chuckcoffee/hukyroaster/README.md

# hukyroaster

<h1>Huky Stove – Gas Automation</h1>

<h2>Materials ~$47.00 CAD</h2>
-	Arduino 
-	Timing Belt and Pulley
-	Scrap wood used for motor mount and track system

Smraza Super Starter Kit (Arduino Clone Kit with stepper motor) - $35.99 Cdn
https://www.amazon.ca/gp/product/B06XXYVWVJ/ref=ppx_yo_dt_b_search_asin_title?ie=UTF8&psc=1
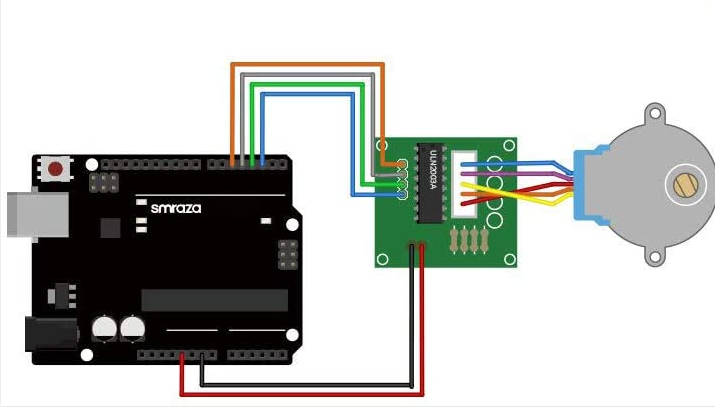
[picture p1: pics/arduino_motor.png]
arduino_motor Arduino setup with motor

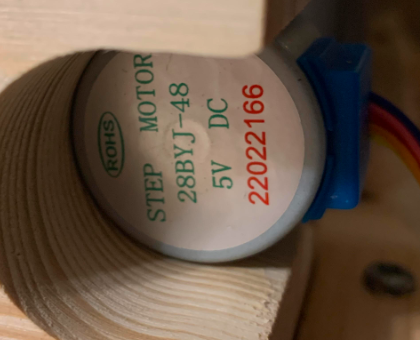
[picture p2: pics/stepper_motor.png]
stepper_motor


Fularr 3D Printer  2mm Pitch/6 mm shaft dia (matches stepper motor and Huky needle valve) - $11.90
https://www.amazon.ca/gp/product/B07PBXGL74/ref=ppx_yo_dt_b_asin_title_o08_s00?ie=UTF8&psc=1
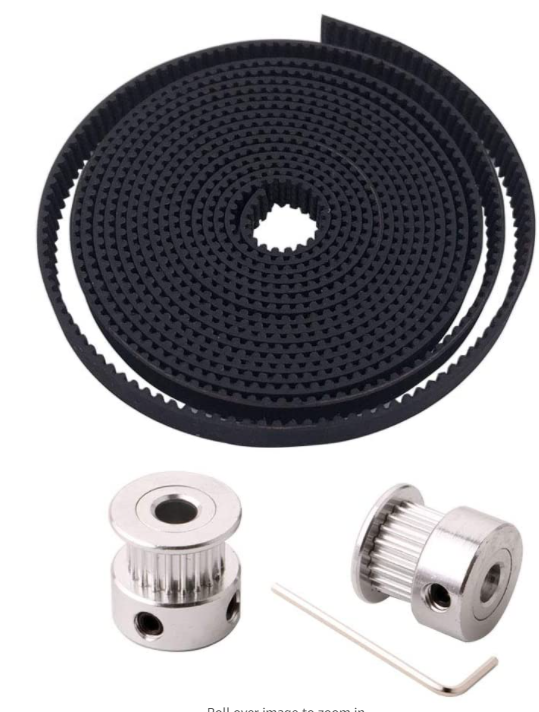
[picture p3: pics/belt.png]
belt


<h2>Files Used</h2>
roaster.ino - Program to run on arduino  <br>
arduinoCommunicator.py - Runs in bg at start, receives all commands from artisanprog calls, sends to arduino over serial connection <br>
artisanprog.py - Sends commands to arduinoCommunicator on button presses or events  <br>
e.g. artisanprog.py KPAI 50 (Set motor position to 50% of kpa_max)

<h2>Initial Setup Steps</h2>
1. Download python 2.7 https://www.python.org/downloads/release/python-278/ <br>

2. Load Arduino script onto Arduino (roaster.ino) <br>

	a. Test motor function <br>

3. Setup Computer to have Artisan interface with Stepper Motor <br>

	a. Create folder for Artisanprog.py and Arduinocommunicator.py and save files there <br>

	b. Setup buttons in artisan to trigger Artisanprog.py <br>

4. Test <br>

	a. From Command prompt execute Arduinocommunicator.py (so it is awake), or create a button in artisan to start the program (artisan setup part b) <br>
	
	b. From Artisan – click buttons and verify stepper motor is responding <br>
	
5. Calibration <br>

	a. Determine amount of rotation for full gas and calculate number of steps (based on stepper motor specs. For this motor, one rotation = 4076 steps; full gas was 1 1/4 turns so kpa max is 5095 steps) note: this was taken starting from 0.5 kpa to allow manual startup and because the motor was not powerful enough to reliably turn the valve if it was closed tight <br>

	b. Assign the max number of steps to kpa_max in artisanprog.py <br>

6. Artisan setup <br>

	a. In buttons tab, create buttons to start and stop the Arduino communicator. <br>
	
start_stop <br>

	b. In the events tab create a slider that gets the KPAI value and set it to burner; call program; C:\Python27\python.exe C:\Users\User\Documents\Arduino\hukyroaster-master\artisanprog.py KPAI {} <br>
	
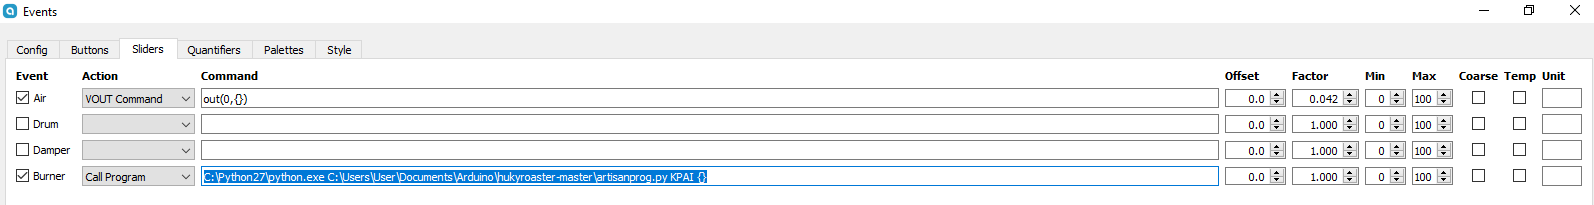
[picture p4: pics/artisan_sliders.png]
sliders
 <br>

	c. Press the button to start Arduino communicator, and then use the slider to adjust the gas until you reach kPa value you want to create a button for. Record these values (100 is max kPa, 0 is 0.5kPa) <br>

	d. Create a button for each kPa value, adjusting the number at the end of the documentation column command line as well as the value of the slider to the recorded values; C:\Python27\python.exe C:\Users\User\Documents\Arduino\hukyroaster-master\artisanprog.py KPAI 100 <br>
	
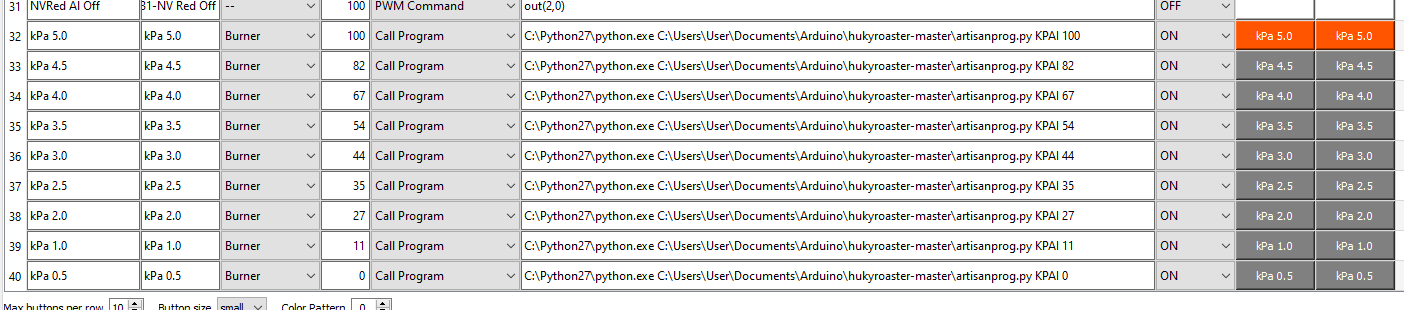
[picture p5: pics/artisan_buttons_2.png]
buttons_2


	e. Create alarms for each button to trigger at specified temperatures setting action to event button and the description as the button number (i.e. event Nr 22 is triggered when the bean temp reaches 340 which triggers event button 37, setting the gas to 2.5kPa) Note: set time to 00:00. This tells artisan to ignore time and only trigger based on temp. <br>

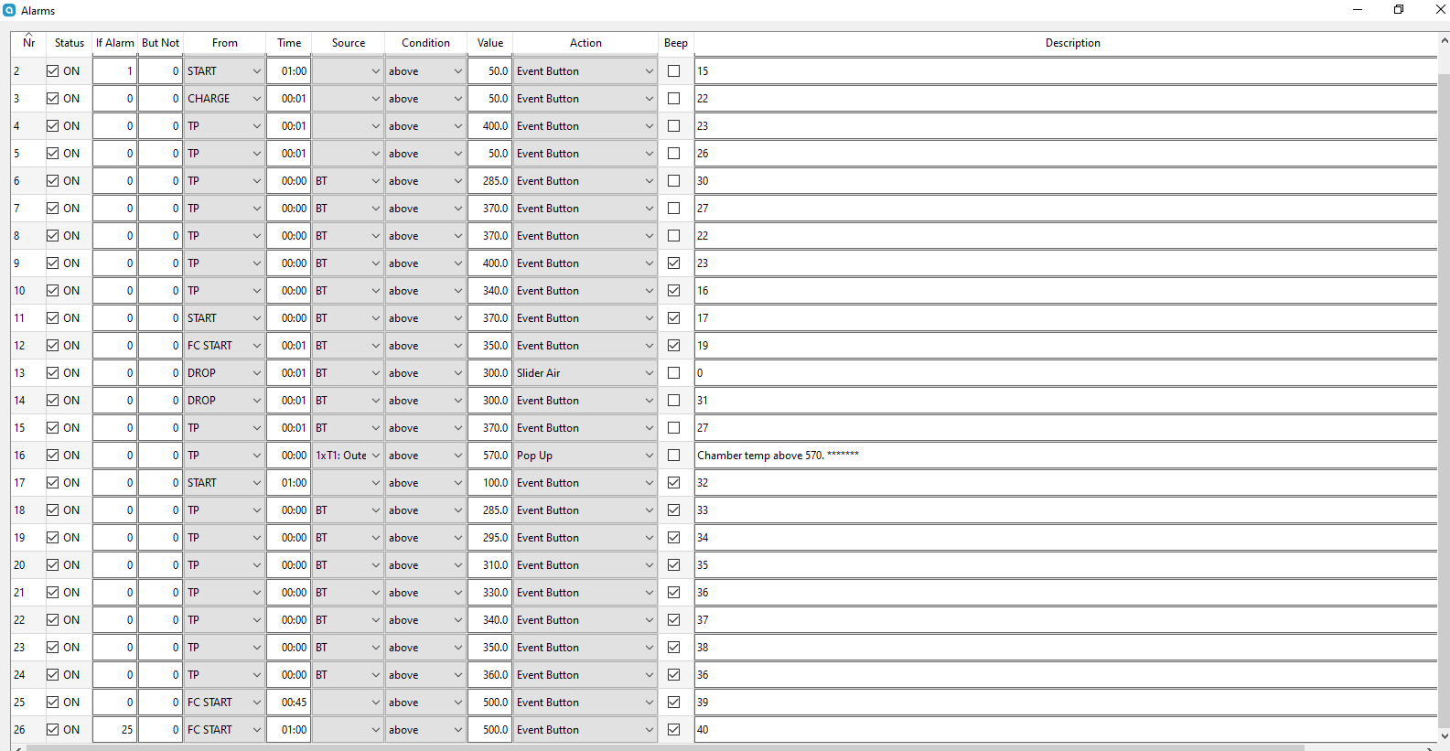
[picture p6: pics/artisan_events.png]
artisan_events

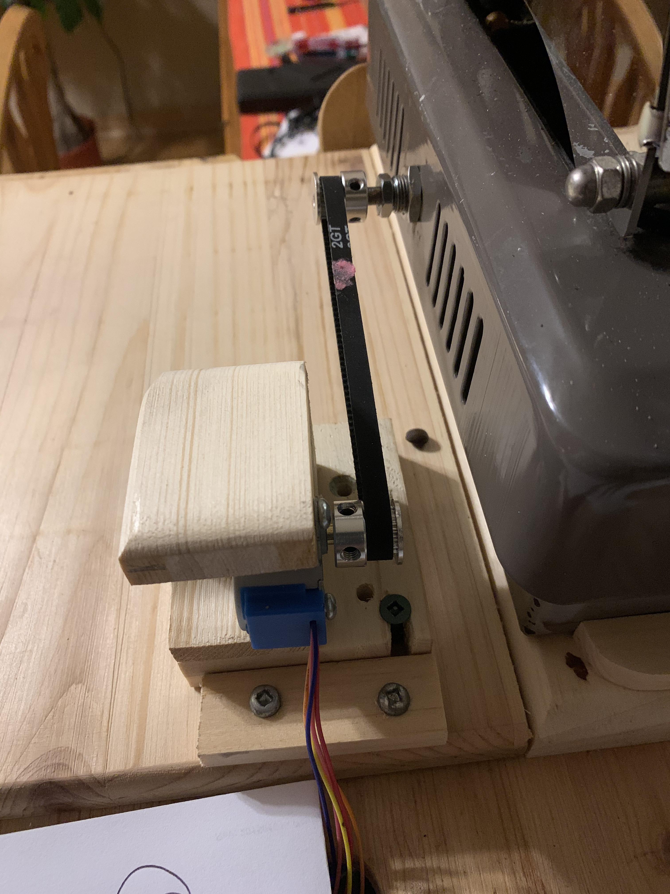
[picture p7: pics/motor_belt_setup.jpg]
setup

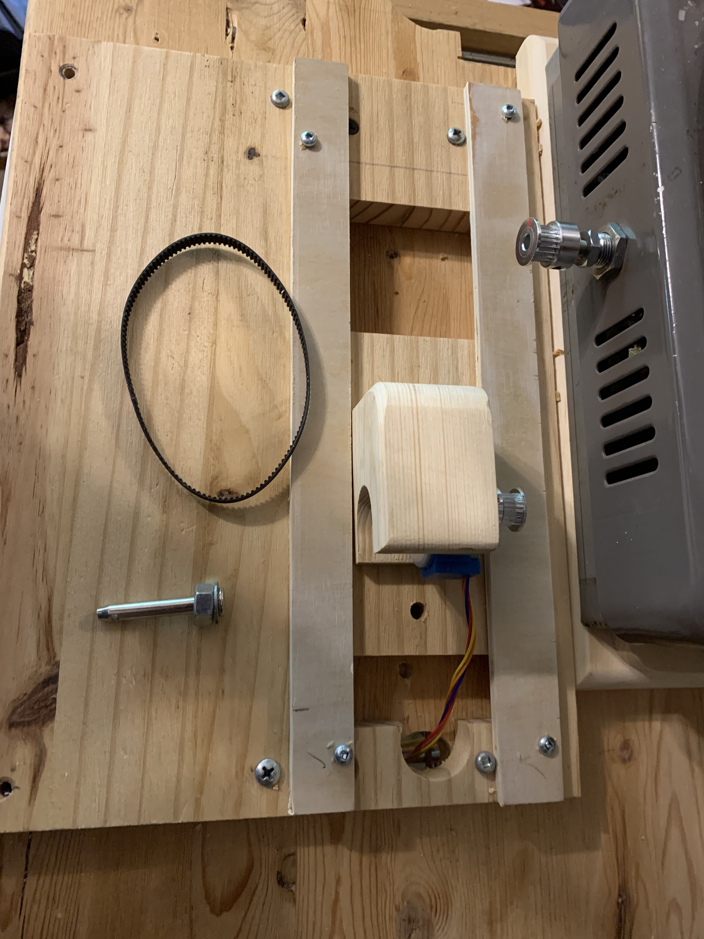
[picture p8: pics/motor_belt_setup_2.jpg]
setup

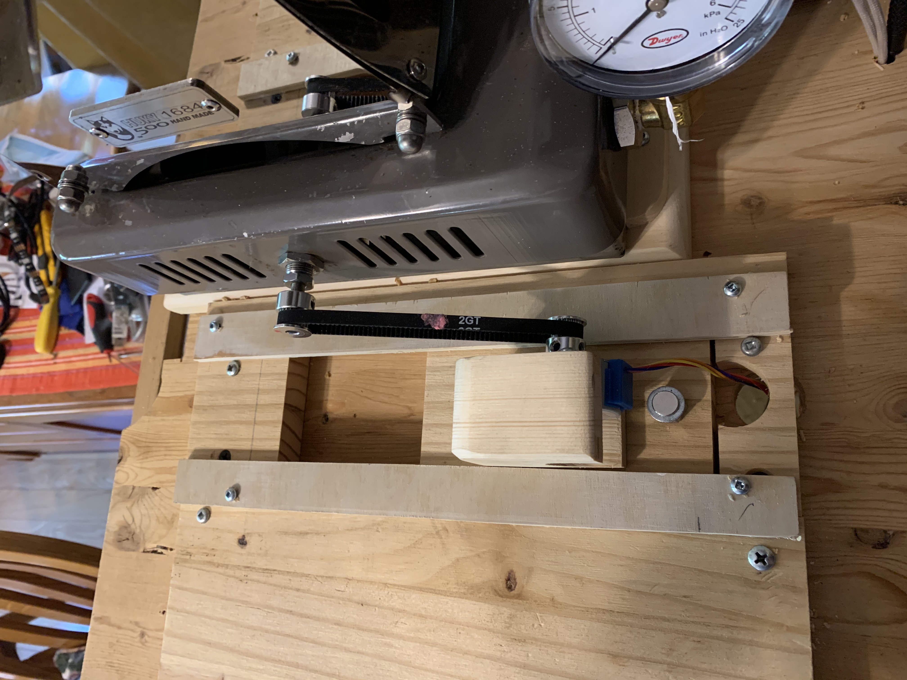
[picture p9: pics/motor_belt_setup_3.jpg]
setup
